erhvan21/PhaseB_Beta/PCB_Design/plots/PCB_Assembly/pcb_top.png

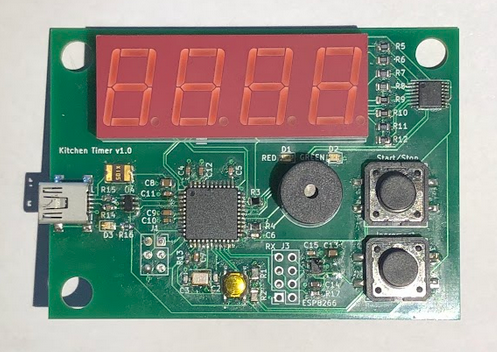
PCB_Design/plots/PCB_Assembly/pcb_top.png
