erhvan21/PhaseB_Beta/Arduino_Code/code_flowChart_aivosto.png

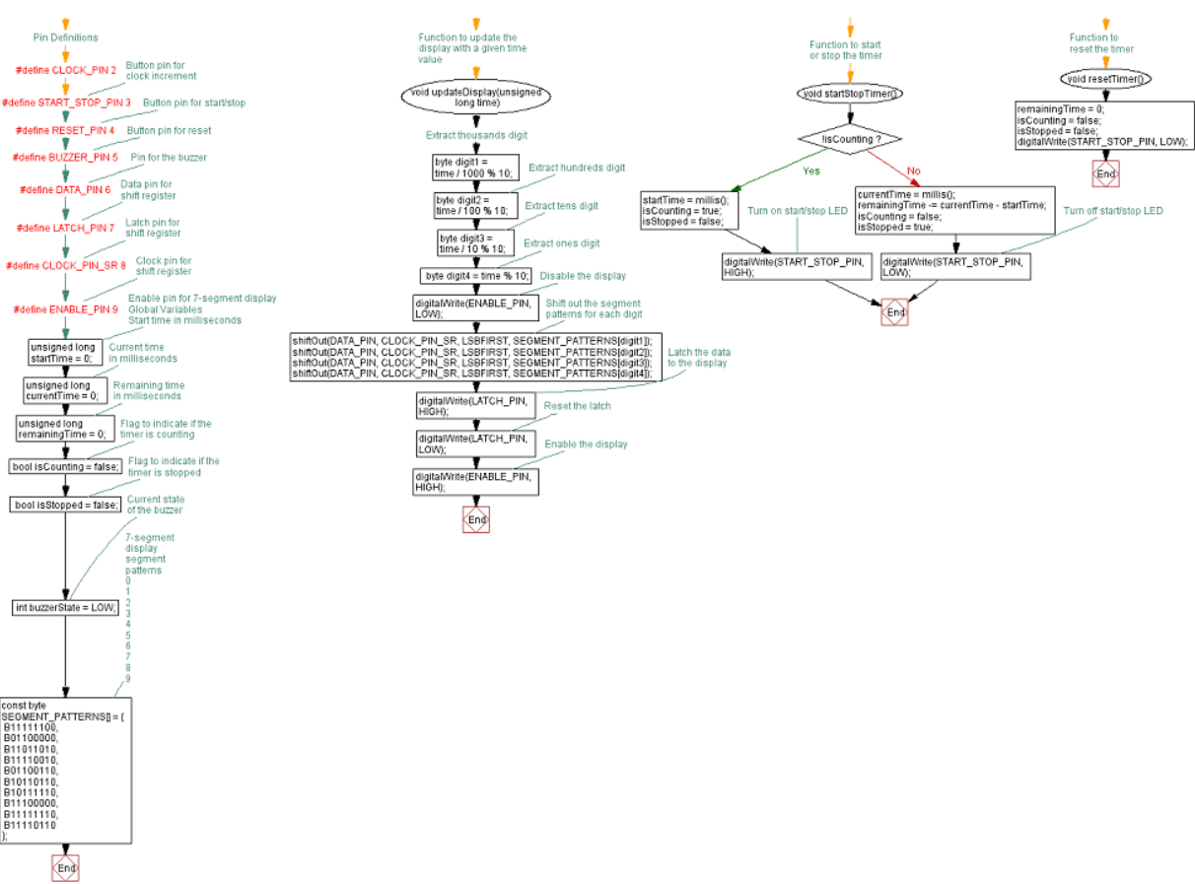
Arduino_Code/code_flowChart_aivosto.png
