erhvan21/PhaseB_Beta/PCB_Design/enclosure/enclosure_bottom.png

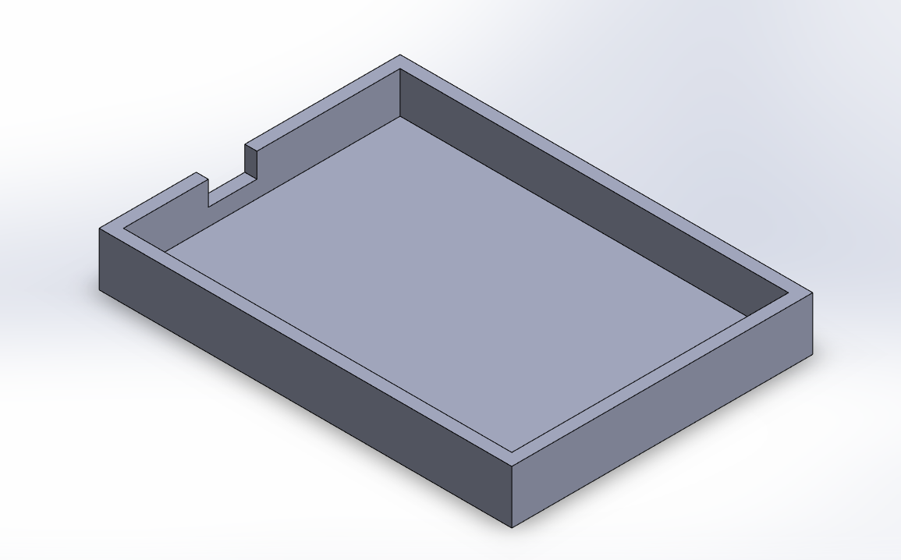
PCB_Design/enclosure/enclosure_bottom.png
