erhvan21/PhaseB_Beta/PCB_Design/enclosure/enclosure_top.png

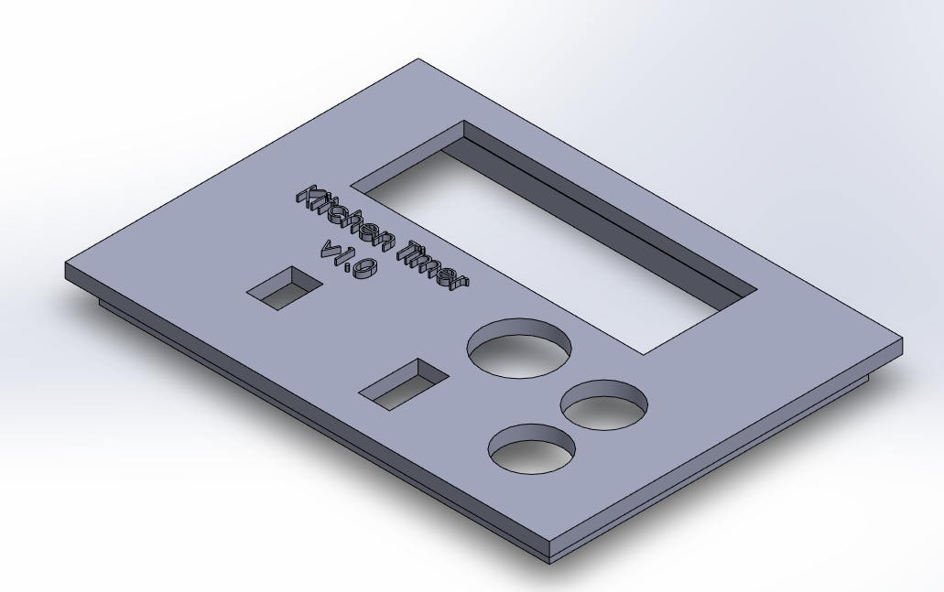
PCB_Design/enclosure/enclosure_top.png
