erhvan21/PhaseB_Beta/PCB_Design/plots/Enclosure3DPrint/bottom_side.png

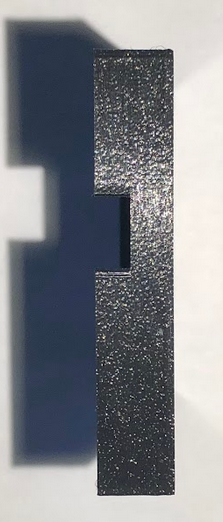
PCB_Design/plots/Enclosure3DPrint/bottom_side.png
