erhvan21/PhaseB_Beta/PCB_Design/plots/Enclosure3DPrint/bottom_top.png

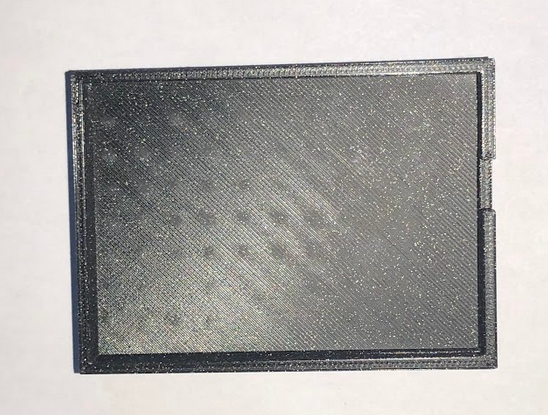
PCB_Design/plots/Enclosure3DPrint/bottom_top.png
