erhvan21/PhaseB_Beta/PCB_Design/plots/Enclosure3DPrint/pcb_bottom_side.png

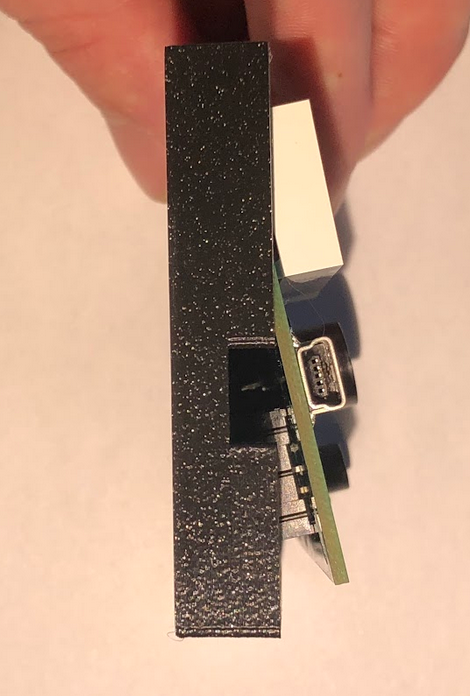
PCB_Design/plots/Enclosure3DPrint/pcb_bottom_side.png
