erhvan21/PhaseB_Beta/PCB_Design/plots/Enclosure3DPrint/pcb_top_top.png

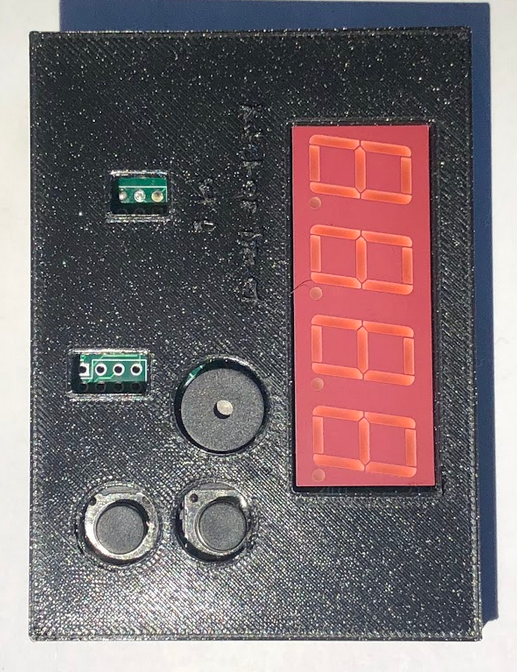
PCB_Design/plots/Enclosure3DPrint/pcb_top_top.png
