erhvan21/PhaseB_Beta/PCB_Design/plots/Enclosure3DPrint/top_bottom.png

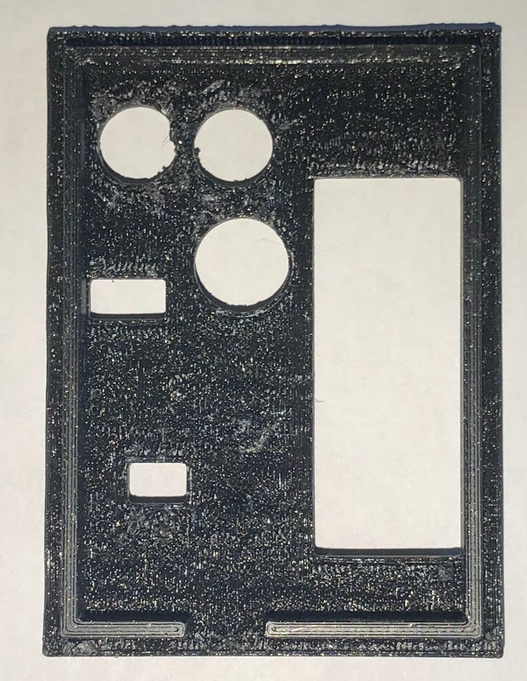
PCB_Design/plots/Enclosure3DPrint/top_bottom.png
