erhvan21/PhaseB_Beta/PCB_Design/schematics/Components/PTS125_SMD_Button/STEP/PTS125_SMD_Button.stp

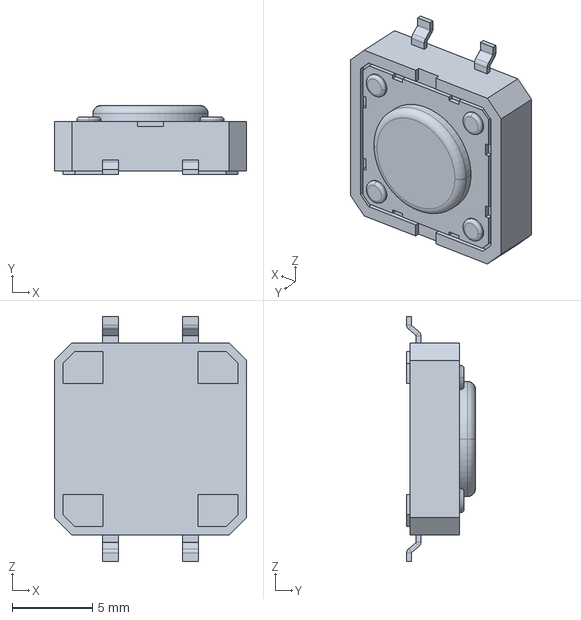
[picture p18: CAD file, 2023-06-08]
PCB_Design/schematics/Components/PTS125_SMD_Button/STEP/PTS125_SMD_Button.stp
12.0 x 4.30 x 15.3 mm
