erhvan21/PhaseB_Beta/PCB_Design/schematics/Components/PTS526_SMD_Button/STEP/PTS526_SMD_Button.step

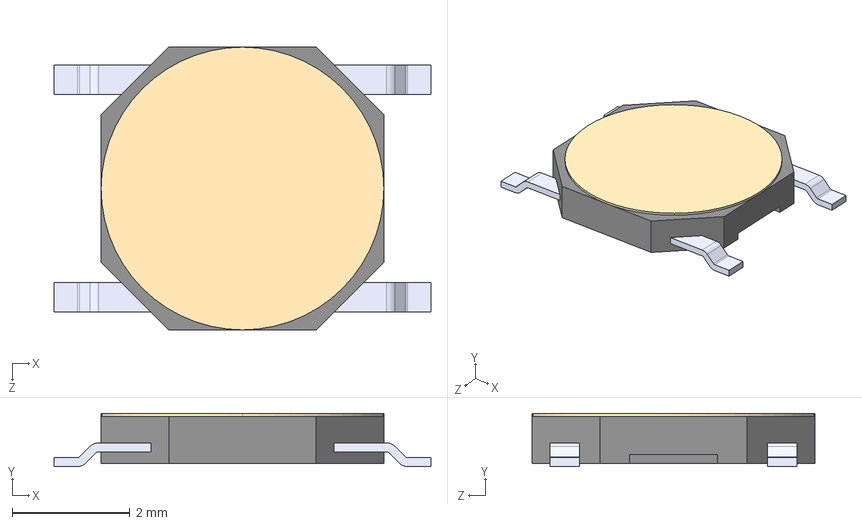
[picture p19: CAD file, 2023-06-08]
PCB_Design/schematics/Components/PTS526_SMD_Button/STEP/PTS526_SMD_Button.step
6.40 x 0.9 x 4.80 mm
