erhvan21/PhaseB_Beta/PCB_Design/step/enclosure_top.STEP

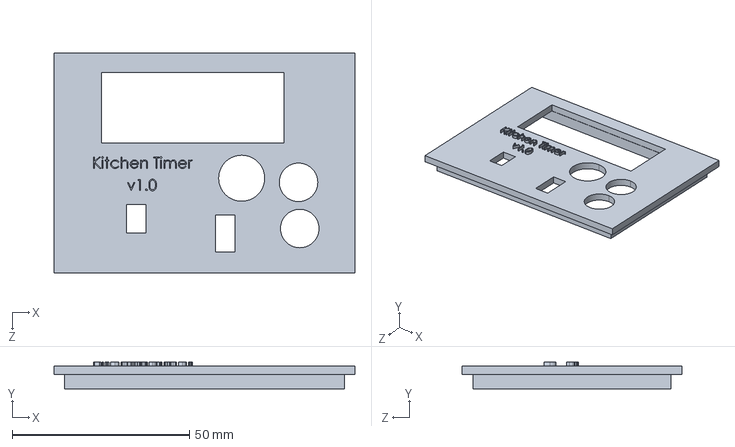
[picture p20: CAD file, 2023-06-08]
PCB_Design/step/enclosure_top.STEP
85.0 x 7.50 x 62.0 mm
