erhvan21/PhaseB_Beta/PCB_Design/step/enclosure_bottom.STEP

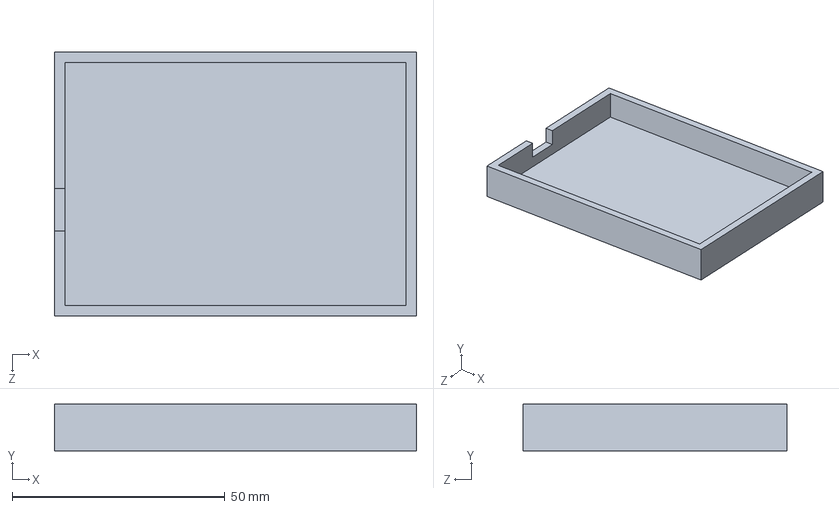
[picture p21: CAD file, 2023-06-08]
PCB_Design/step/enclosure_bottom.STEP
85.0 x 11.0 x 62.0 mm
