erhvan21/PhaseB_Beta/PCB_Design/enclosure/enclosure_assembly.png

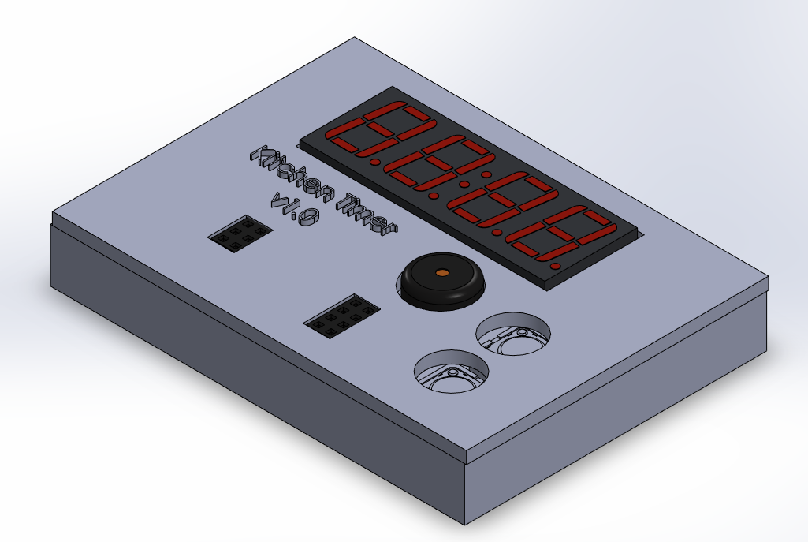
PCB_Design/enclosure/enclosure_assembly.png
