erhvan21/PhaseB_Beta/PCB_Design/plots/PCB_Assembly/pcb_bottom.png

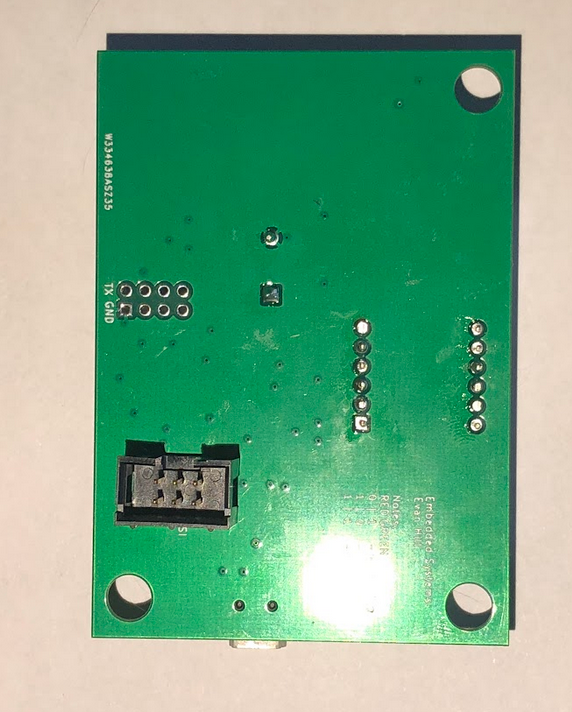
PCB_Design/plots/PCB_Assembly/pcb_bottom.png
