erhvan21/PhaseB_Beta/PCB_Design/enclosure/enclosure_bottom_design.PDF

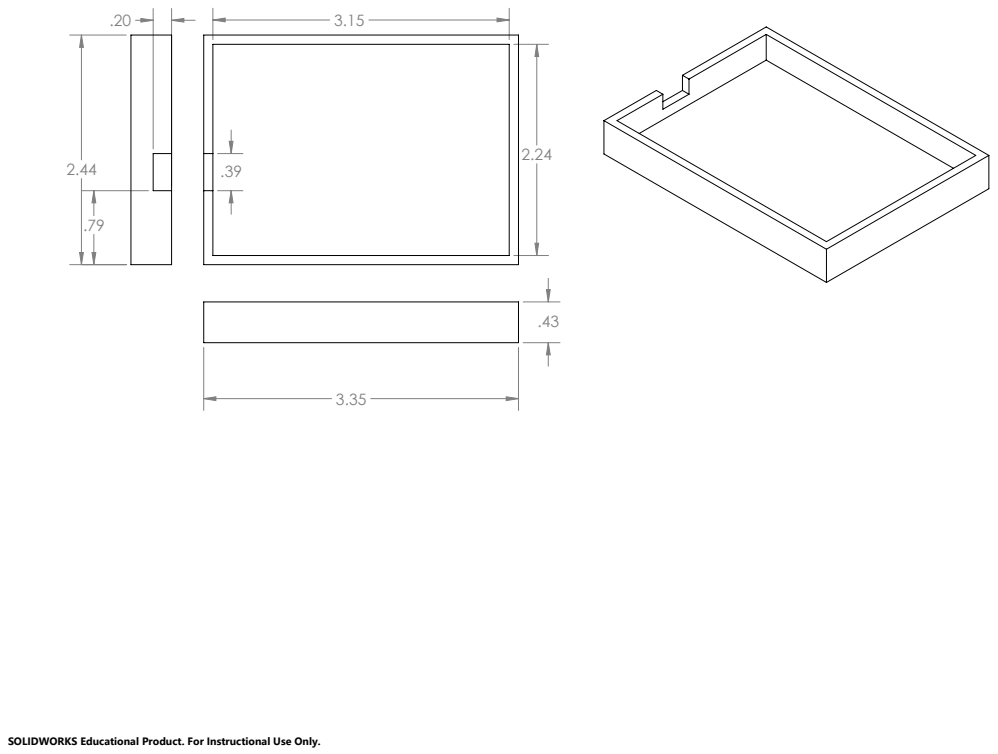
[picture p25: page 1]

SOLIDWORKS Educational Product. For Instructional Use Only.
