erhvan21/PhaseB_Beta/PCB_Design/enclosure/enclosure_top_design.PDF

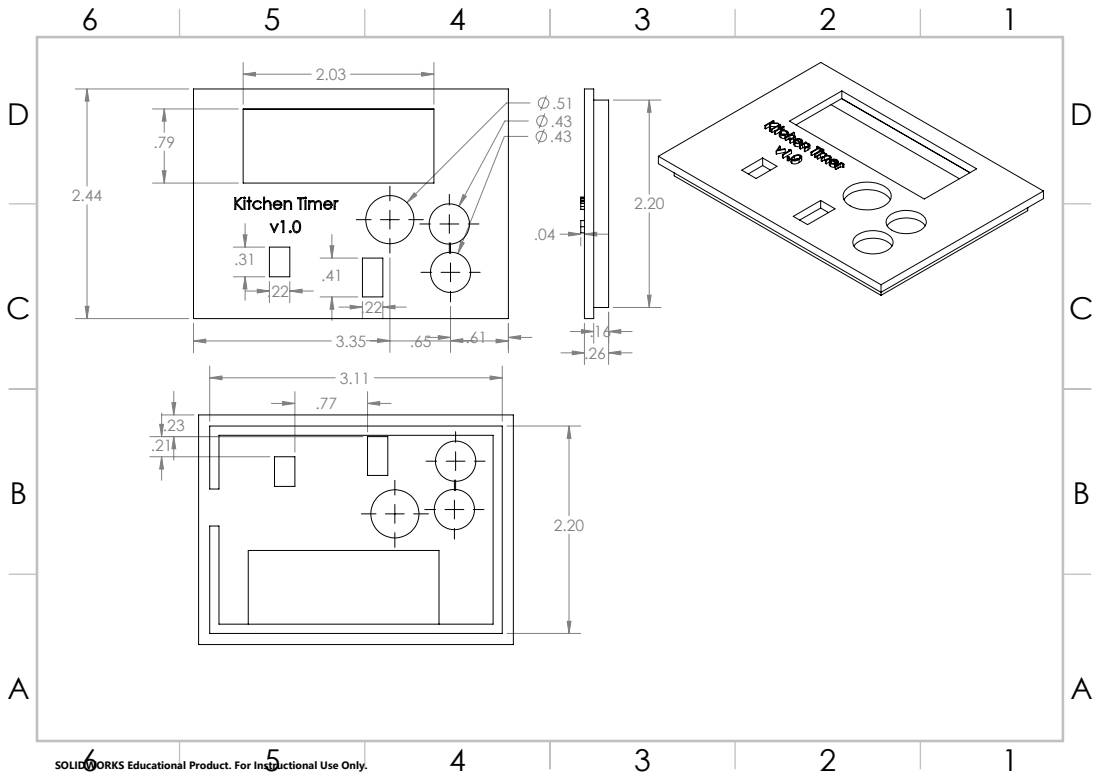
[picture p26: page 1]

SOLIDWORKS Educational Product. For Instructional Use Only.
