erhvan21/PhaseB_Beta/PCB_Design/plots/circuit_schematic.pdf

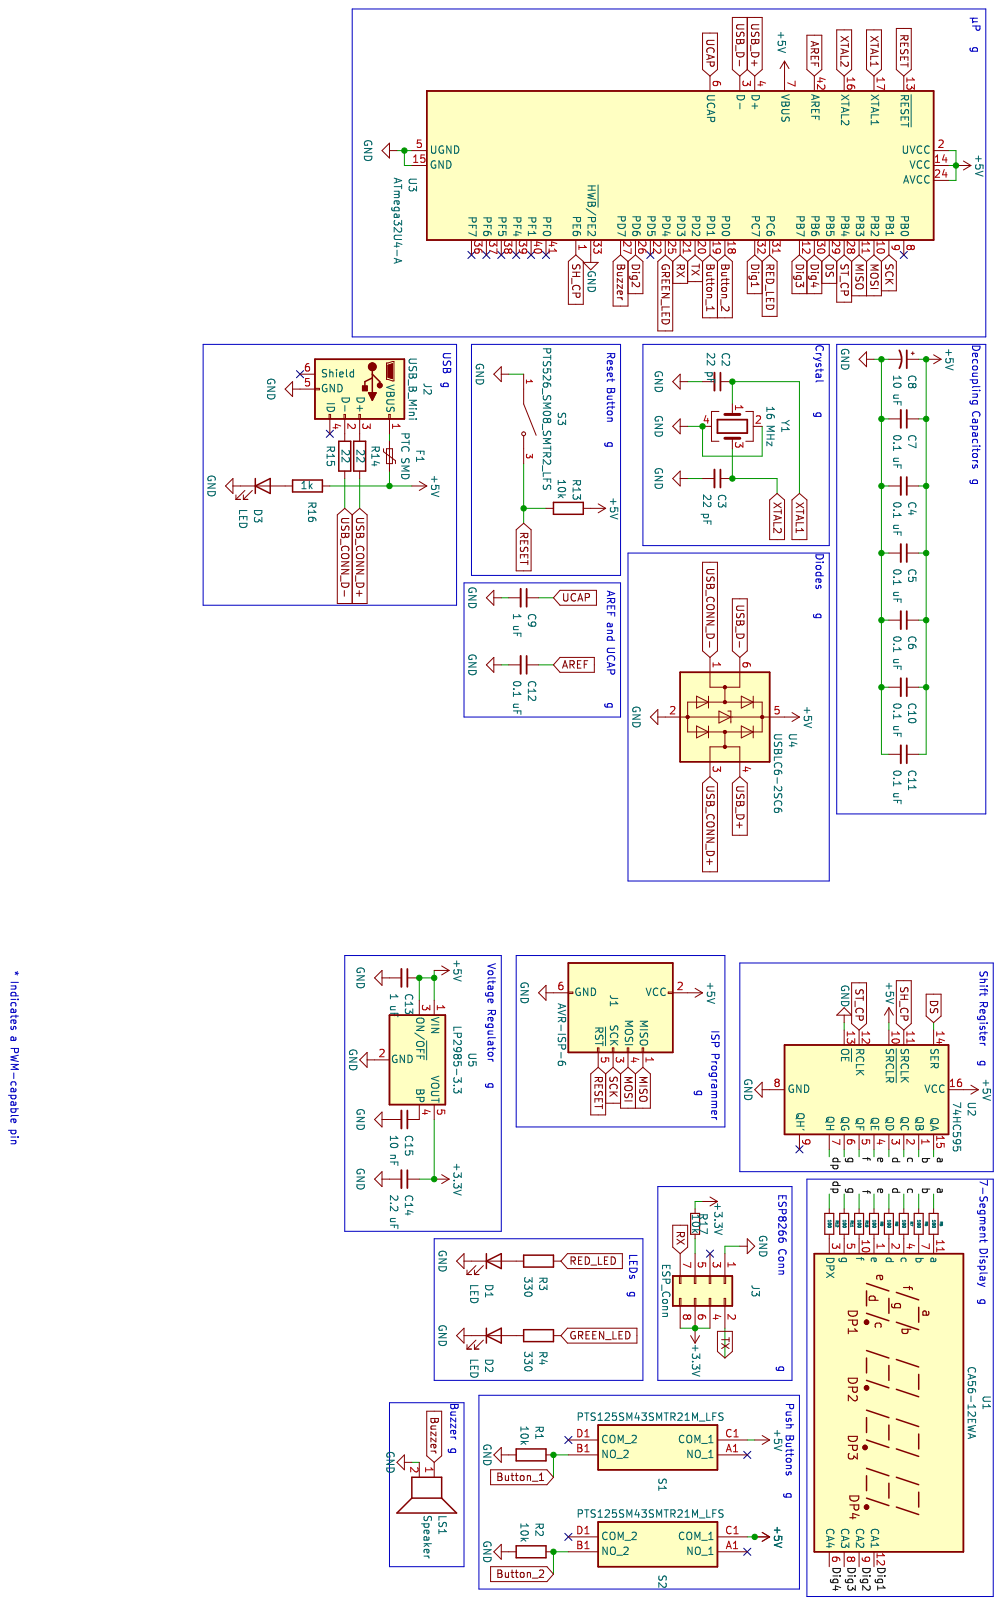
[picture p27: page 1]
