erhvan21/PhaseB_Beta/PCB_Design/plots/pcb_schematic.pdf

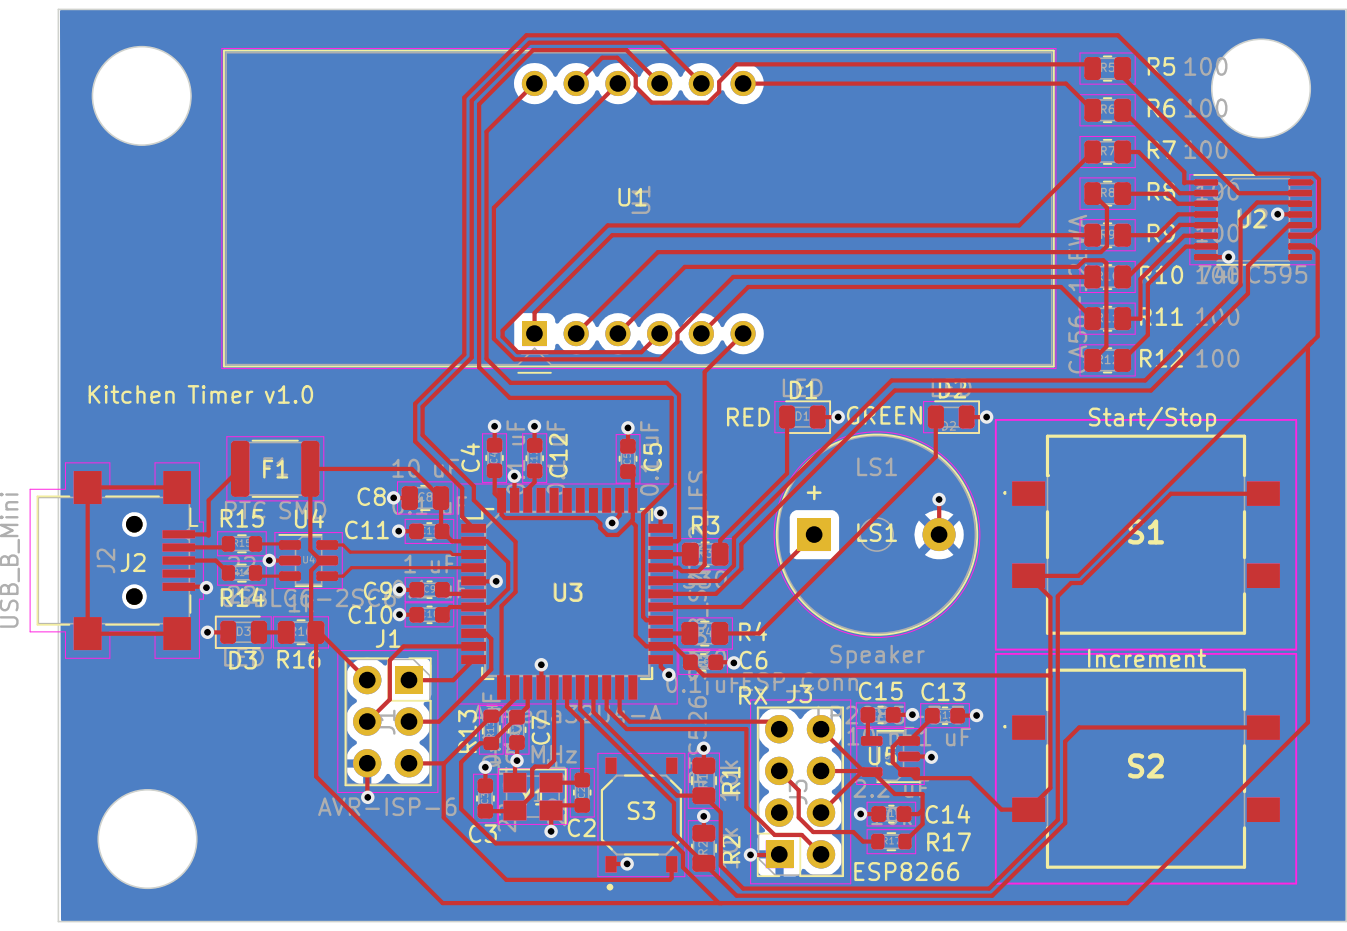
[picture p28: page 1]
